HexabitzPlatform/H08R6x-Hardware/Released/BOM/H08R6.xlsx

 |  | www.hexabitz.com info@hexabitz.com |  | Bill Of Materials
Customer | Hexabitz | Revision | 2
Project | Hexabitz Modules | Date | 2024-12-11
Board | VL53L8 IR ToF LiDar Sensor (H08R6) | Notes
Designator | Description | Manufacturer Part Number | Manufacturer | Octopart Url | Quantity
JP1 | PCB Header, Unshrouded, Thru 02 Straight Header, .101, AMPMODU Mod II Series | 5-146280-1 | TE Connectivity | https://octopart.com/5-146280-1-te+connectivity+%2F+amp-40259676?r=sp (https://octopart.com/87227-1-te+connectivity-39512052?r=sp) | 1
JP2 | Conn Unshrouded Header HDR 3 POS 2.54mm Solder ST Top Entry Thru-Hole Carton | 5-146281-3 | TE Connectivity | https://octopart.com/5-146281-3-te+connectivity+%2F+amp-39745942?r=sp | 1
C1, C5, C6, C8, C9, C10, C14, C15, C16, C17 | CAP 0402 0,1UF 16V TDK Multilayer Ceramic Capacitors MLCC-SMD/SMT | CGA2B1X7R1C104K050BC | TDK | https://octopart.com/cga2b1x7r1c104k050bc-tdk-26014376?r=sp (https://octopart.com/c0603c104k8ractu-kemet-145075?r=sp&s=9bS9ASSwSEqMCE9KBEQZ0g) | 10
C13 | CAP CER 1UF 10V X5R 0402 | C0402C105K8PAC7411 | KEMET | https://octopart.com/c0402c105k8pac7411-kemet-75146233?r=sp | 1
C2 | CAP CER 1UF 10V X5R 0603 | GRM188R61A105KA61J | MURATA | https://octopart.com/grm188r61a105ka61j-murata-9221870?r=sp (https://octopart.com/cc0805kkx7r7bb105-yageo-8376555?r=sp) | 1
C11, C7 | Multilayer Ceramic Capacitors MLCC - SMD/SMT 0603 25V 4.7uF X5R 10% T: 0.8mm | C1608X5R1E475K080AC | TDK | https://octopart.com/c1608x5r1e475k080ac-tdk-26013502?r=sp (https://octopart.com/10tpu4r7msi-panasonic-29487748?r=sp) | 2
C12 | Multilayer Ceramic Capacitor, 10 uF, 10 V, ± 20%, X5R, 0402 [1005 Metric] | CL05A106MP8NUB8 | Samsung | https://octopart.com/cl05a106mp8nub8-samsung-68086897?r=sp | 1
R2 | RES SMD 0 OHM JUMPER 1/16W 0402 | AC0402JR-070RL | YAGEO | https://octopart.com/ac0402jr-070rl-yageo-21711084?r=sp (https://octopart.com/rc0603jr-070rl-yageo-1241539?r=sp) | 1
R1 | Thick Film Resistors - SMD 0402 1%270ohm | ERJ-PA2F2700X | Panasonic | https://octopart.com/search?q=ERJ-PA2F2700X&currency=USD&specs=0 (https://octopart.com/erj-3geyj271v-panasonic-55560546) | 1
R5, R6 | RES SMD 1K OHM 1% 1/16W 0402 | RC0402FR-071KL | YAGEO | https://octopart.com/rc0402fr-071kl-yageo-55402862?r=sp (https://octopart.com/search?q=060300F2201T5E&currency=USD&specs=0) | 2
R3 ,R4, R11 | RES 10K OHM 1% Yageo Thick Film Resistors -SMD 1/16W 0402 | RC0402FR-0710KL | YAGEO | https://octopart.com/rc0402fr-0710kl-yageo-55458461?r=sp (https://octopart.com/search?q=RC0603FR-0710KL&currency=USD&specs=0) | 3
R5, R6, R7, R8, R9, R10 | SMD 47kOhms 1/16W 0402 1 % | AC0402FR-7W47KL | YAGEO | https://octopart.com/ac0402fr-7w47kl-yageo-96301082?r=sp | 6
R12 | SMD 100 kOhms 62.5 mW 04 02 1% | RC0402FR-7D100KL | YAGEO | https://octopart.com/rc0402fr-7d100kl-yageo-91025184?r=sp | 1
FB1 | Ind chip Bead Multi-Layer 30 ohms 25% 100MHZ Ferrite 1,5A 0603Punched paper T/R | MMZ1608Y300BTA00 | TDK | https://octopart.com/mmz1608y300bta00-tdk-7906990?r=sp (https://octopart.com/search?q=MPZ1608S601ATD25&currency=USD&specs=0) | 1
D1 | Red 0603 130° Clear 54 mcd 2 V Surface Mount ChipLED | VLMS1300-GS08 | Vishay (https://octopart.com/manufacturers/wolfspeed) | https://octopart.com/vlms1300-gs08-vishay-21709201?r=sp&s=_gcP4_q8T1SC6PJQPTQ9yA | 1
D2 | TVS DIODE 3,3V 10,9V SOD323 | CDSOD323-T03SC | BOURNS INC | https://octopart.com/cdsod323-t03sc-bourns-10487153?r=sp | 1
U1 | MCU 32-bit ARM Cortex M0+ RISC 512KB Flash 1.8V/2.5V/3.3V 48-Pin UFQFPN EP Tray | STM32G0B1CEU6 | STMicroelectronics | https://octopart.com/stm32g0b1ceu6-stmicroelectronics-116363364?r=sp | 1
U2 | Low-power high-performance 8x8 multizone Time-of-Flight sensor | VL53L8CXV0GC1 | STMicroelectronics | https://octopart.com/vl53l8cxv0gc%2F1-stmicroelectronics-130889878?r=sp | 1
U3 | 300mA current very low noise LDO | LDK130PU18R | STMicroelectronics | https://octopart.com/ldk130pu18r-stmicroelectronics-31691884?r=sp | 1
U4 | Power Distribution Load Switch IC | TCK107AG,LF | Toshiba | https://octopart.com/tck107ag%2Clf%28s-toshiba-68108129?r=sp | 1
U5,U6 | Voltage Level Translator Bidirectional 4 Circuit 1 Channel 2Mbps, 24Mbps 14-TQFN | PI4ULS3V204ZBEX | Diodes Inc | https://octopart.com/pi4uls3v204zbex-diodes+inc.-81855359?r=sp | 2
X1 | 8,0000MHZ 33pF SMD MURATA Resonators | CSTNE8M00G550000R0 | Murata | https://octopart.com/cstne8m00g550000r0-murata-91406934?r=sp | 1
