HexabitzPlatform/H08R6x-Hardware/Documentation/H08R6 Schematics.pdf

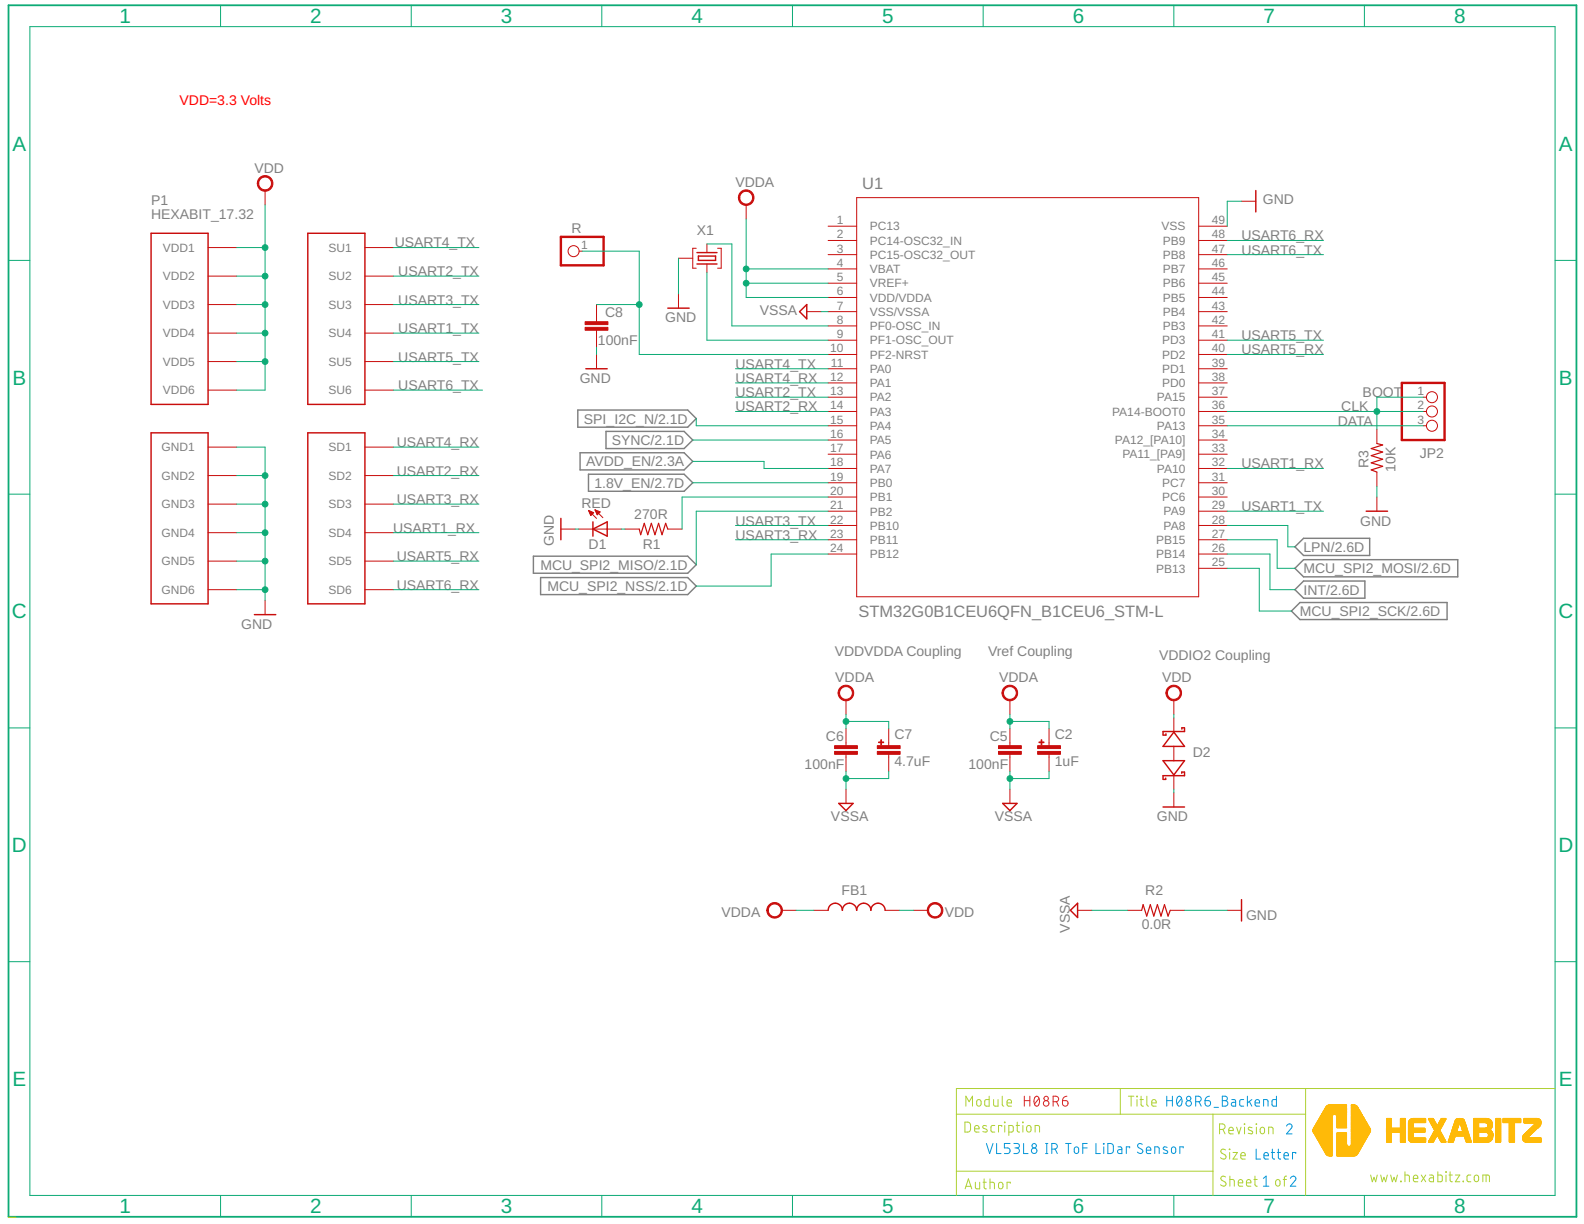
[picture p1: page 1]

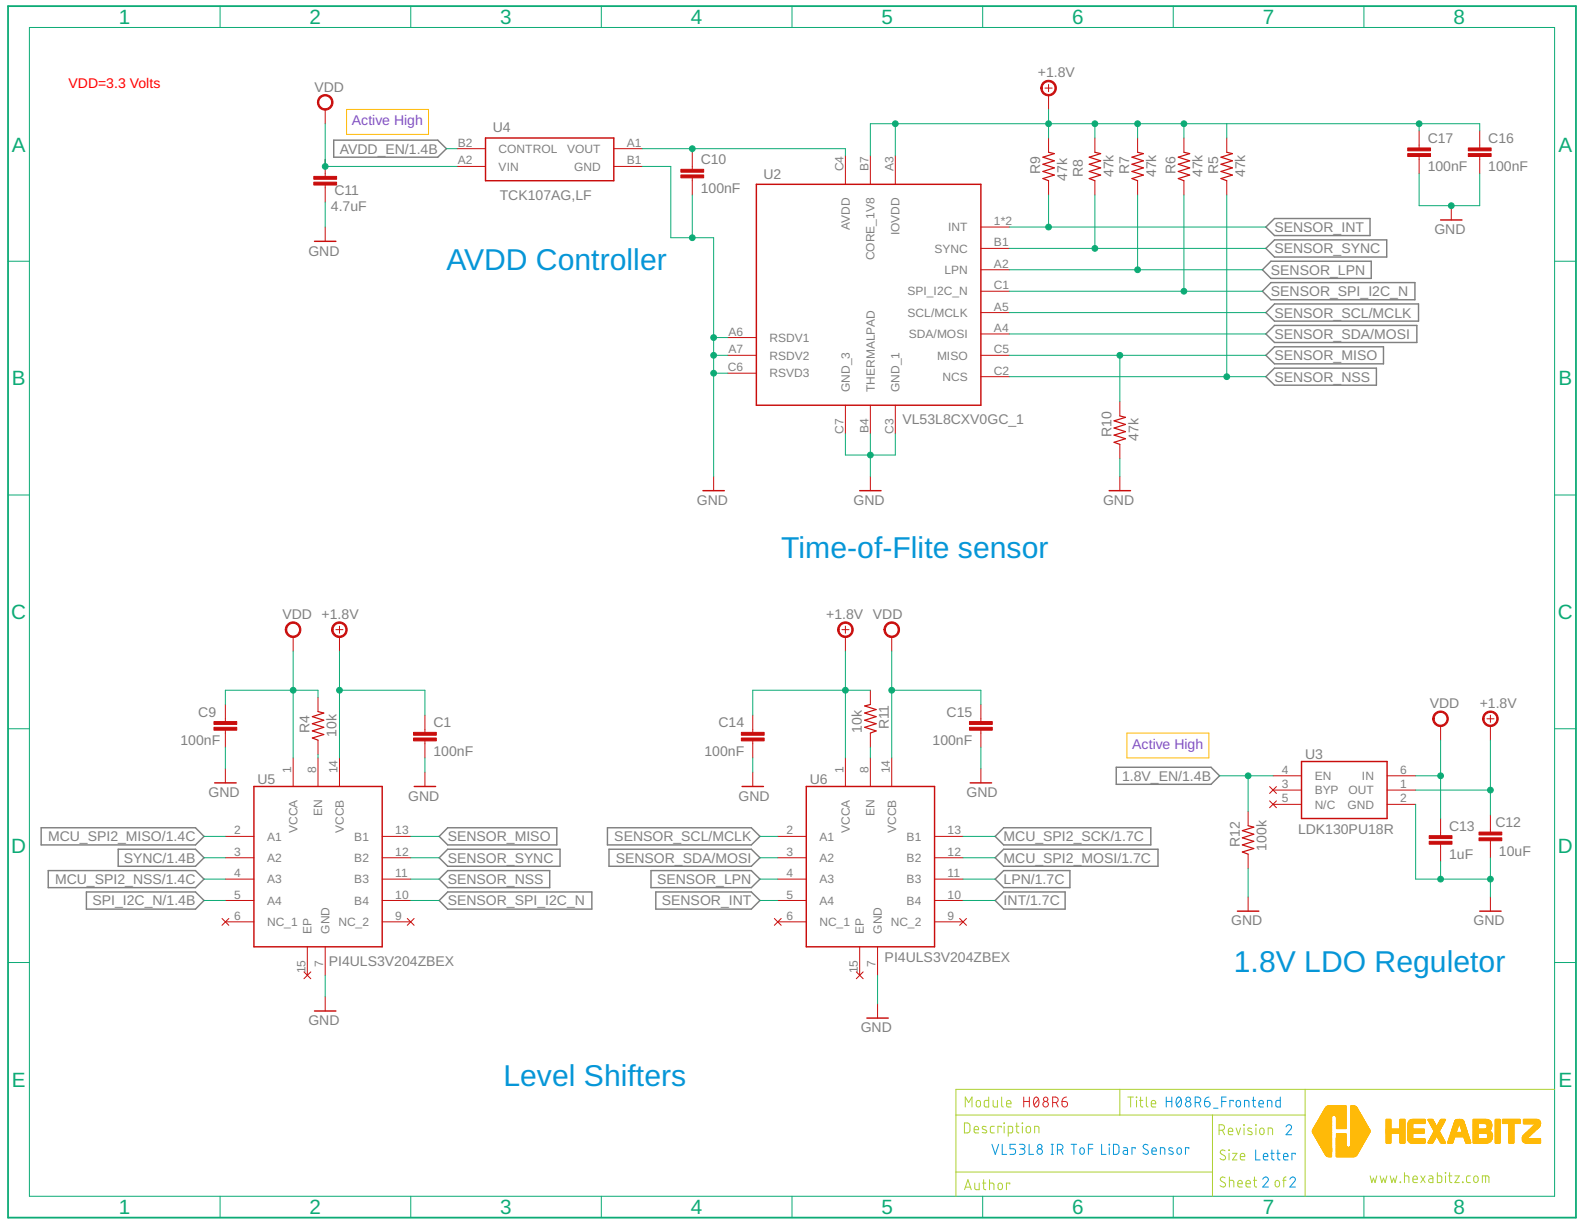
[picture p2: page 2]

A3 SDA/MOSI A4 SCL/MCLK

Time-of-Flite sensor

SENSOR_SCL/MCLK | MCU_SPI2_SCK/1.7C
SENSOR_SDA/MOSI | MCU_SPI2_MOSI/1.7C
