HexabitzPlatform/H08R6x-Hardware/H08R60/Design/H08R60.sch

## EAGLE design H08R60/Design/H08R60.sch (2019-05-23)

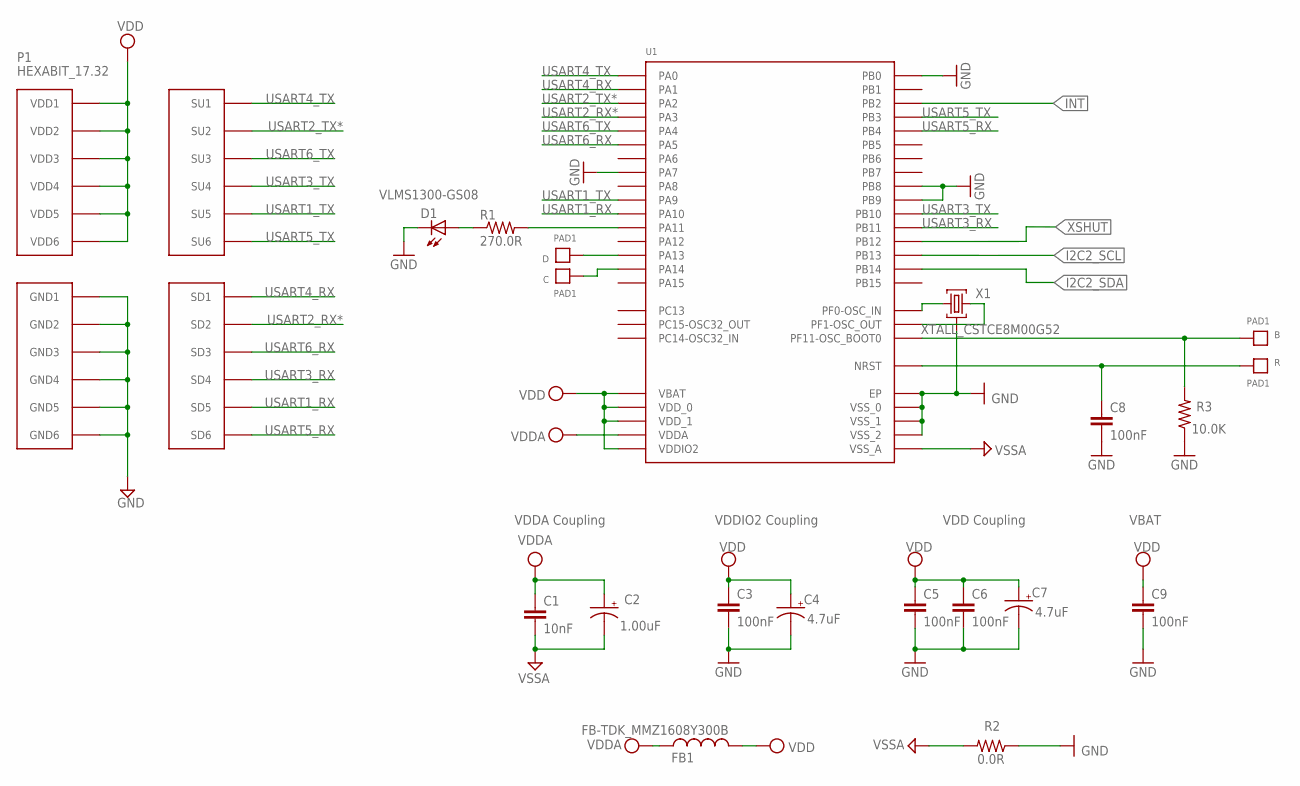
[picture p7: schematic H08R60.sch, sheet 1]

Parts:
B: PAD1
C: PAD1
C1: 10nF; C-0603; TOLERANCE 10%; VOLTAGE_RATING 50V; MPN C0603C103K5RACTU
C2: 1.00uF; C-0805; TOLERANCE 10%; VOLTAGE_RATING 16V; MPN CC0805KKX7R7BB105
C3, C6, C8: 100nF; C-0603; TOLERANCE 10%; VOLTAGE_RATING 10V; MPN C0603C104K8RACTU
C4, C7: 4.7uF; C-0805; TOLERANCE 10%; VOLTAGE_RATING 25V; MPN GRM21BC81E475KA12L
C5: 100nF; C-0603; TOLERANCE 10%; VOLTAGE_RATING 10; MPN C0603C104K8RACTU
C9: 100nF; C-0603; TOLERANCE 10V; VOLTAGE_RATING 10%; MPN C0603C104K8RACTU
D: PAD1
D1: VLMS1300-GS08; MPN VLMS1300-GS08
FB1: FB-TDK_MMZ1608Y300B; MPN MMZ1608Y300B
P1: HEXABIT_17.32
R: PAD1
R1: 270.0R; R-0603; TOLERANCE 1%; MPN RC0603FR-07270RL
R2: 0.0R; R-0603; MPN RC0603JR-070RL
R3: 10.0K; R-0603; TOLERANCE 5%; MPN RC0603JR-0710KL
U1: STM32F091CBU6
X1: XTALL_CSTCE8M00G52

Connections:
B1: B.P$1, R3.2, U1.P$44 (PF11-OSC_BOOT0)
GND: C3.2, C4.2 (-), C5.2, C6.2, C7.2 (-), C8.2, C9.2, D1.C, P1.PAD_PD7 (GND1), P1.PAD_PD8 (GND2), P1.PAD_PD9 (GND3), P1.PAD_PD10 (GND4), P1.PAD_PD11 (GND5), P1.PAD_PD12 (GND6), R2.1, R3.1, U1.EP, U1.P$17 (PA7), U1.P$18 (PB0), U1.P$23 (VSS_0), U1.P$35 (VSS_1), U1.P$45 (PB8), U1.P$46 (PB9), U1.P$47 (VSS_2), X1.P$2 (2)
I2C2_SCL: U1.P$26 (PB13)
I2C2_SDA: U1.P$27 (PB14)
INT: U1.P$20 (PB2)
unnamed: R1.2, U1.P$32 (PA11)
unnamed: D1.A, R1.1
unnamed: U1.P$5 (PF0-OSC_IN), X1.P$1 (1)
unnamed: U1.P$6 (PF1-OSC_OUT), X1.P$3 (3)
unnamed: D.P$1, U1.P$34 (PA13)
unnamed: C.P$1, U1.P$37 (PA14)
R1: C8.1, R.P$1, U1.P$7 (NRST)
USART1_RX: P1.PAD_PD5 (SD5), U1.P$31 (PA10)
USART1_TX: P1.PAD_PU5 (SU5), U1.P$30 (PA9)
USART2_RX*: P1.PAD_PD2 (SD2), U1.P$13 (PA3)
USART2_TX*: P1.PAD_PU2 (SU2), U1.P$12 (PA2)
USART3_RX: P1.PAD_PD4 (SD4), U1.P$22 (PB11)
USART3_TX: P1.PAD_PU4 (SU4), U1.P$21 (PB10)
USART4_RX: P1.PAD_PD1 (SD1), U1.P$11 (PA1)
USART4_TX: P1.PAD_PU1 (SU1), U1.P$10 (PA0)
USART5_RX: P1.PAD_PD6 (SD6), U1.P$40 (PB4)
USART5_TX: P1.PAD_PU6 (SU6), U1.P$39 (PB3)
USART6_RX: P1.PAD_PD3 (SD3), U1.P$15 (PA5)
USART6_TX: P1.PAD_PU3 (SU3), U1.P$14 (PA4)
VDD: C3.1, C4.1 (+), C5.1, C6.1, C7.1 (+), C9.1, FB1.2, P1.PAD_PU7 (VDD1), P1.PAD_PU8 (VDD2), P1.PAD_PU9 (VDD3), P1.PAD_PU10 (VDD4), P1.PAD_PU11 (VDD5), P1.PAD_PU12 (VDD6), U1.P$1 (VBAT), U1.P$24 (VDD_0), U1.P$36 (VDDIO2), U1.P$48 (VDD_1)
VDDA: C1.1, C2.1 (+), FB1.1, U1.P$9 (VDDA)
VSSA: C1.2, C2.2 (-), R2.2, U1.P$8 (VSS_A)
XSHUT: U1.P$25 (PB12)

Notes on the sheet:
VDDA Coupling
VDDIO2 Coupling
VDD Coupling
VBAT

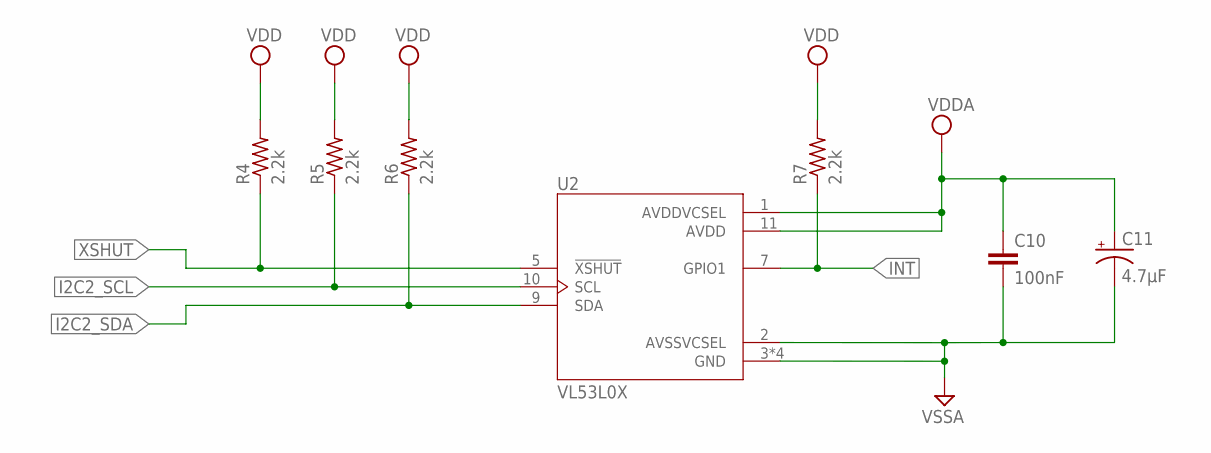
[picture p8: schematic H08R60.sch, sheet 2]

Parts:
C10: 100nF; C-0603; TOLERANCE ±10%; VOLTAGE_RATING 16.0 V; MPN C0603C104K8RACTU
C11: 4.7uF; C-0805; TOLERANCE 10%; VOLTAGE_RATING 25V; MPN GRM21BC81E475KA12L
R4, R5, R6, R7: 2.2k; R-0603; TOLERANCE ±1%; MPN RC0603FR-07270RL
U2: VL53L0X; SENSOR_VL53L0X

Connections:
AGND: C10.2, C11.2 (-), U2.2 (AVSSVCSEL), U2.3 (GND)
I2C2_SCL: R5.1, U2.10 (SCL)
I2C2_SDA: R6.1, U2.9 (SDA)
INT: R7.1, U2.7 (GPIO1)
VDD: C10.1, C11.1 (+), R4.2, R5.2, R6.2, R7.2, U2.1 (AVDDVCSEL), U2.11 (AVDD)
XSHUT: R4.1, U2.5 (!XSHUT)
