HexabitzPlatform/H08R6x-Hardware/(commit log)

2019-05-23 First release rev 0
    [H08R60.brd, H08R60.sch, H08R60.xlsx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]
2022-12-21 - Changing the MC to STM32G0 - Editing the electronic design to improve the performance
    [H08R60.brd, H08R60.xlsx, H08R61.brd, H08R61.sch, H08R61.xlsx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]
2023-02-13 -Correcting some documentation issues
    [H08R61.brd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]
2024-01-20 -The final design, all done. -Upgrade the IR sensor and use VL53L8.
    [H08R6.brd, H08R6.sch, H08R6.xlsx, H08R61.brd, H08R61.sch, H08R61.xlsx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]
2024-01-29 Correct the EN pin of the level shifter IC referencing.
    [H08R6.brd, H08R6.sch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]
2024-04-04 Update the description
    [H08R6.sch, H08R6.xlsx]
2024-04-30 -Fix missing connection -Add TVS -Update the logo -Fix clearence and soldermask
    [H08R6.brd, H08R6.sch, H08R6.xlsx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]
2024-12-11 -Change the MCU footprint to STM32G0B1CEU6
    [H08R6.brd, H08R6.sch, H08R6.xlsx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]
2024-12-13 Fix BOM
    [H08R6.xlsx]
2024-12-26 Add the TVS to the BOM
    [H08R6.xlsx]
